kunlunliu2/Control_module_for_a_robotic_navigation_system/MyPCB5.jpg

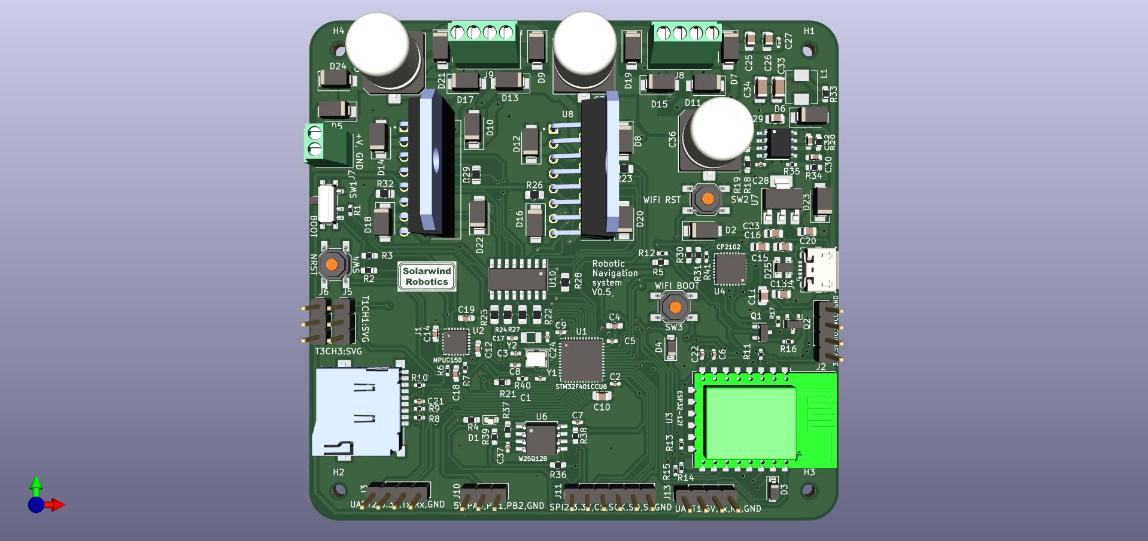
MyPCB5.jpg
