kunlunliu2/Control_module_for_a_robotic_navigation_system/README.md

# Control_module_for_a_robotic_navigation_system
This repository is my control module design for my home robot. The module will drive 4 electric motors and two other servos. It contains a ESP32 wifi, MPU9150, CP2102, L298n, and STM32F103 chips. The module is designed for recording Lidar, Gyro, and magnetic data, which are need for position recognition and motion planning. The cost of module for making and components is about $30 ~$50 depending on the manufacturing.
