kunlunliu2/Control_module_for_a_robotic_navigation_system/MyPCB5c.jpg

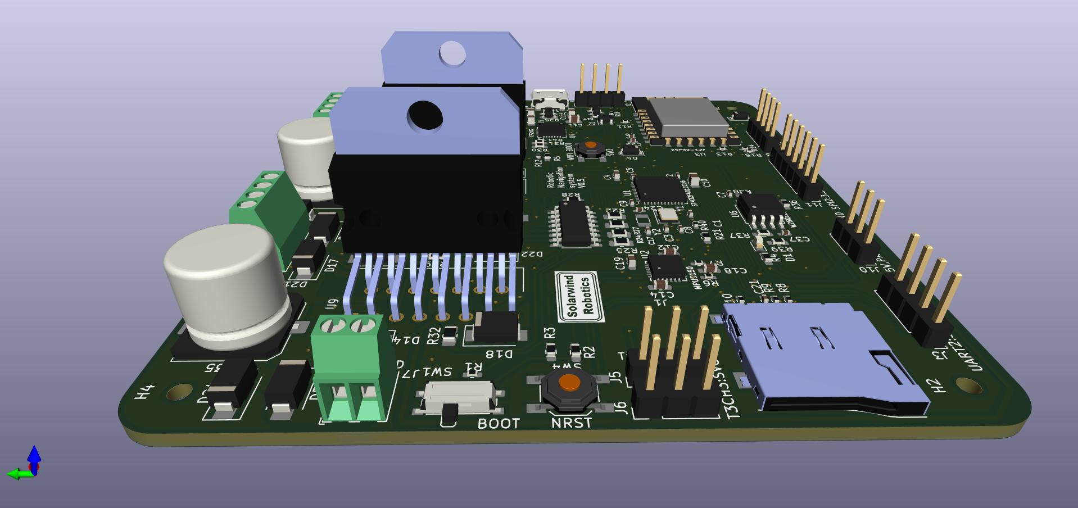
MyPCB5c.jpg
