kunlunliu2/Control_module_for_a_robotic_navigation_system/MCU.kicad_sch

## KiCad design MCU.kicad_sch (2022-03-09)

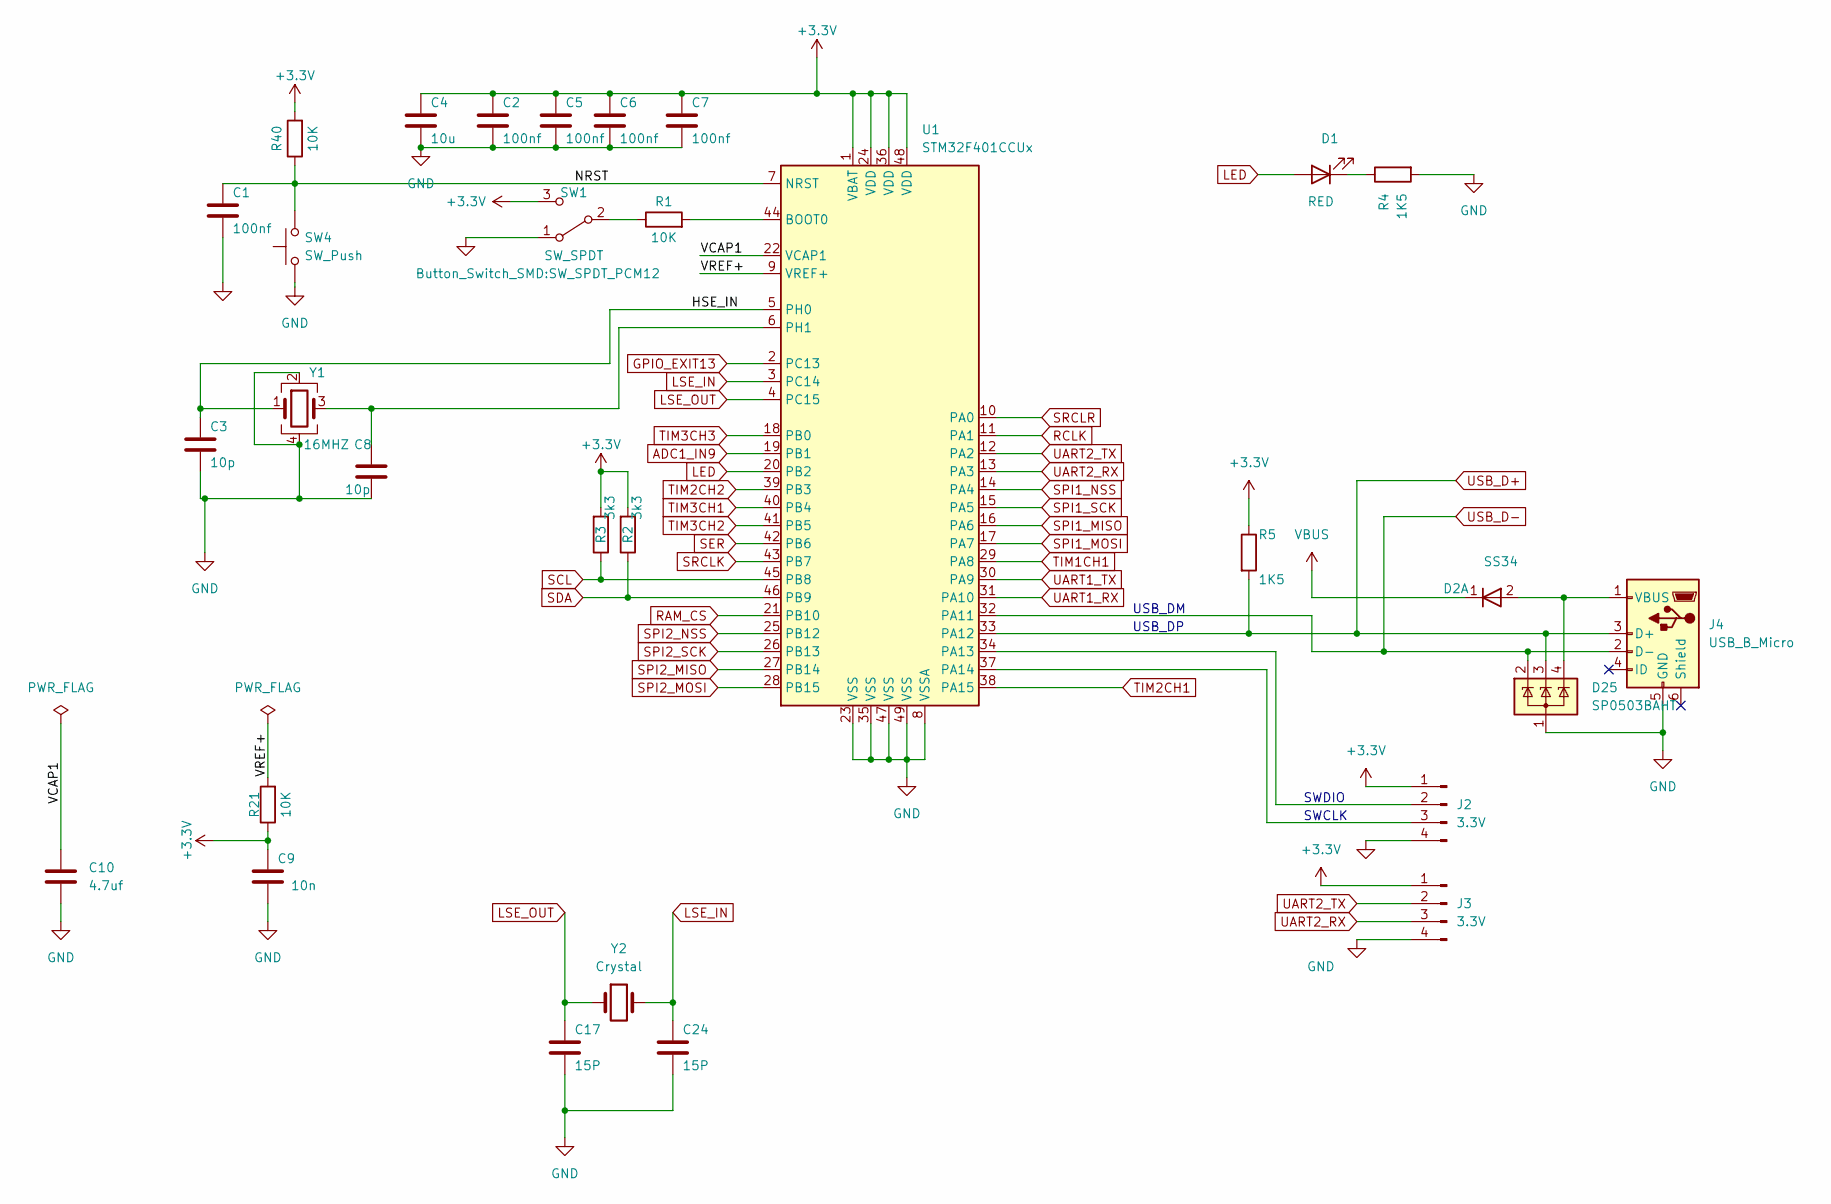
[picture p5: schematic MCU.kicad_sch]

Parts:
C1, C2, C5, C6, C7: 100nf; C_0402_1005Metric_Pad0.74x0.62mm_HandSolder; LCSC C307331
C3, C8: 10p; C_0402_1005Metric_Pad0.74x0.62mm_HandSolder; LCSC C32949
C4: 10u; C_0603_1608Metric_Pad1.08x0.95mm_HandSolder; LCSC C19702
C9: 10n; C_0402_1005Metric_Pad0.74x0.62mm_HandSolder; LCSC C15195
C10: 4.7uf; C_0805_2012Metric_Pad1.18x1.45mm_HandSolder; LCSC C1779
C17, C24: 15P; C_0402_1005Metric_Pad0.74x0.62mm_HandSolder; LCSC C1548
D1: RED; LED_0603_1608Metric; LCSC C72041
D2: SS34; D_SMA; LCSC C8678
D25: SP0503BAHT; SOT-143; LCSC C2682275
J2, J3: 3.3V; PinHeader_1x04_P2.54mm_Vertical; LCSC C358686
J4: USB_B_Micro; USB_Micro-B_Amphenol_10118194_Horizontal; LCSC C132563
R1, R40: 10K; R_0402_1005Metric_Pad0.72x0.64mm_HandSolder; LCSC C25744
R2, R3: 3k3; R_0603_1608Metric_Pad0.98x0.95mm_HandSolder; LCSC C22978
R4, R5: 1K5; R_0603_1608Metric_Pad0.98x0.95mm_HandSolder; LCSC C22843
R21: 10K; R_0603_1608Metric_Pad0.98x0.95mm_HandSolder; LCSC C25804
SW1: SW_SPDT; SW_SPDT_PCM12; LCSC C431541
SW4: SW_Push; SW_SPST_SKQG_WithoutStem; LCSC C318884
U1: STM32F401CCUx; QFN-48-1EP_7x7mm_P0.5mm_EP5.6x5.6mm
Y1: 16MHZ; Crystal_SMD_3225-4Pin_3.2x2.5mm; LCSC C13738
Y2: Crystal; Crystal_SMD_3215-2Pin_3.2x1.5mm; LCSC C32346

Connections:
+3.3V: C2.1, C4.1, C5.1, C6.1, C7.1, C9.1, J2.1, J3.1, R2.2, R3.2, R5.1, R21.1, R40.2, SW1.3 (C), U1.1 (VBAT), U1.24 (VDD), U1.36 (VDD), U1.48 (VDD)
ADC1_IN9: U1.19 (PB1)
GND: C1.2, C2.2, C3.2, C4.2, C5.2, C6.2, C7.2, C8.2, C9.2, C10.2, C17.2, C24.2, D25.1 (A), J2.4, J3.4, J4.5 (GND), R4.2, SW1.1 (A), SW4.1, U1.8 (VSSA), U1.23 (VSS), U1.35 (VSS), U1.47 (VSS), U1.49 (VSS), Y1.2, Y1.4
GPIO_EXIT13: U1.2 (PC13)
HSE_IN: C3.1, U1.5 (PH0), Y1.1
LED: D1.2 (A), U1.20 (PB2)
LSE_IN: C24.1, U1.3 (PC14), Y2.2
LSE_OUT: C17.1, U1.4 (PC15), Y2.1
NRST: C1.1, R40.1, SW4.2, U1.7 (NRST)
unnamed: C8.1, U1.6 (PH1), Y1.3
unnamed: D1.1 (K), R4.1
unnamed: D2.2 (A), D25.4 (K), J4.1 (VBUS)
unnamed: J2.2, U1.34 (PA13)
unnamed: J2.3, U1.37 (PA14)
unnamed: R1.1, SW1.2 (B)
unnamed: R1.2, U1.44 (BOOT0)
RAM_CS: U1.21 (PB10)
RCLK: U1.11 (PA1)
SCL: R3.1, U1.45 (PB8)
SDA: R2.1, U1.46 (PB9)
SER: U1.42 (PB6)
SPI1_MISO: U1.16 (PA6)
SPI1_MOSI: U1.17 (PA7)
SPI1_NSS: U1.14 (PA4)
SPI1_SCK: U1.15 (PA5)
SPI2_MISO: U1.27 (PB14)
SPI2_MOSI: U1.28 (PB15)
SPI2_NSS: U1.25 (PB12)
SPI2_SCK: U1.26 (PB13)
SRCLK: U1.43 (PB7)
SRCLR: U1.10 (PA0)
TIM1CH1: U1.29 (PA8)
TIM2CH1: U1.38 (PA15)
TIM2CH2: U1.39 (PB3)
TIM3CH1: U1.40 (PB4)
TIM3CH2: U1.41 (PB5)
TIM3CH3: U1.18 (PB0)
UART1_RX: U1.31 (PA10)
UART1_TX: U1.30 (PA9)
UART2_RX: J3.3, U1.13 (PA3)
UART2_TX: J3.2, U1.12 (PA2)
USB_D+: D25.3 (K), J4.3 (D+), R5.2, U1.33 (PA12)
USB_D-: D25.2 (K), J4.2 (D-), U1.32 (PA11)
VBUS: D2.1 (K)
VCAP1: C10.1, U1.22 (VCAP1)
VREF+: R21.2, U1.9 (VREF+)

Notes on the sheet:
SWDIO
USB_DP
USB_DM
SWCLK
