kunlunliu2/Control_module_for_a_robotic_navigation_system/MPU9150.kicad_sch

## KiCad design MPU9150.kicad_sch (2022-03-09)

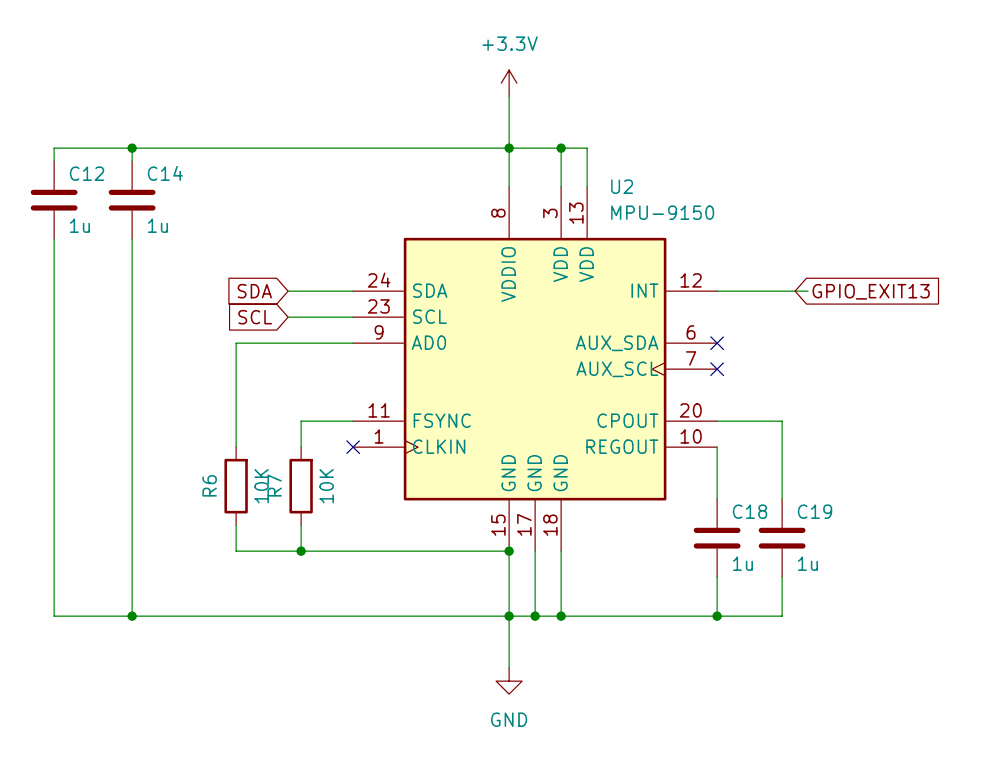
[picture p6: schematic MPU9150.kicad_sch]

Parts:
C12, C14, C18, C19: 1u; C_0603_1608Metric_Pad1.08x0.95mm_HandSolder; LCSC C15849
R6, R7: 10K; R_0402_1005Metric_Pad0.72x0.64mm_HandSolder; LCSC C25744
U2: MPU-9150; InvenSense_QFN-24_4x4mm_P0.5mm; LCSC C71459

Connections:
+3.3V: C12.1, C14.1, U2.3 (VDD), U2.8 (VDDIO), U2.13 (VDD)
GND: C12.2, C14.2, C18.2, C19.2, R6.1, R7.1, U2.15 (GND), U2.17 (GND), U2.18 (GND)
GPIO_EXIT13: U2.12 (INT)
unnamed: C18.1, U2.10 (REGOUT)
unnamed: C19.1, U2.20 (CPOUT)
unnamed: R6.2, U2.9 (AD0)
unnamed: R7.2, U2.11 (FSYNC)
SCL: U2.23 (SCL)
SDA: U2.24 (SDA)
