kunlunliu2/Control_module_for_a_robotic_navigation_system/RAM.kicad_sch

## KiCad design RAM.kicad_sch (2022-03-09)

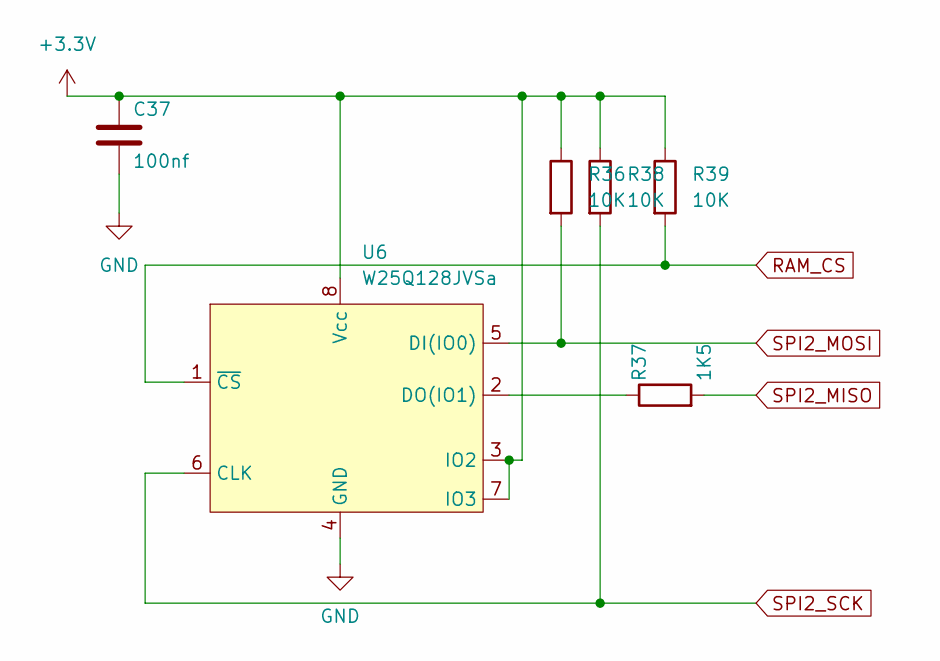
[picture p7: schematic RAM.kicad_sch]

Parts:
C37: 100nf; C_0402_1005Metric_Pad0.74x0.62mm_HandSolder; LCSC C307331
R36, R38, R39: 10K; R_0603_1608Metric_Pad0.98x0.95mm_HandSolder; LCSC C25804
R37: 1K5; R_0603_1608Metric_Pad0.98x0.95mm_HandSolder; LCSC C22843
U6: W25Q128JVSa; SOIC-8_5.23x5.23mm_P1.27mm; LCSC C97521

Connections:
+3.3V: C37.1, R36.1, R38.1, R39.1, U6.3 (IO2), U6.7 (IO3), U6.8 (Vcc)
GND: C37.2, U6.4 (GND)
unnamed: R37.1, U6.2 (DO(IO1))
RAM_CS: R39.2, U6.1 (~CS)
SPI2_MISO: R37.2
SPI2_MOSI: R36.2, U6.5 (DI(IO0))
SPI2_SCK: R38.2, U6.6 (CLK)
