kunlunliu2/Control_module_for_a_robotic_navigation_system/SD.kicad_sch

## KiCad design SD.kicad_sch (2022-03-09)

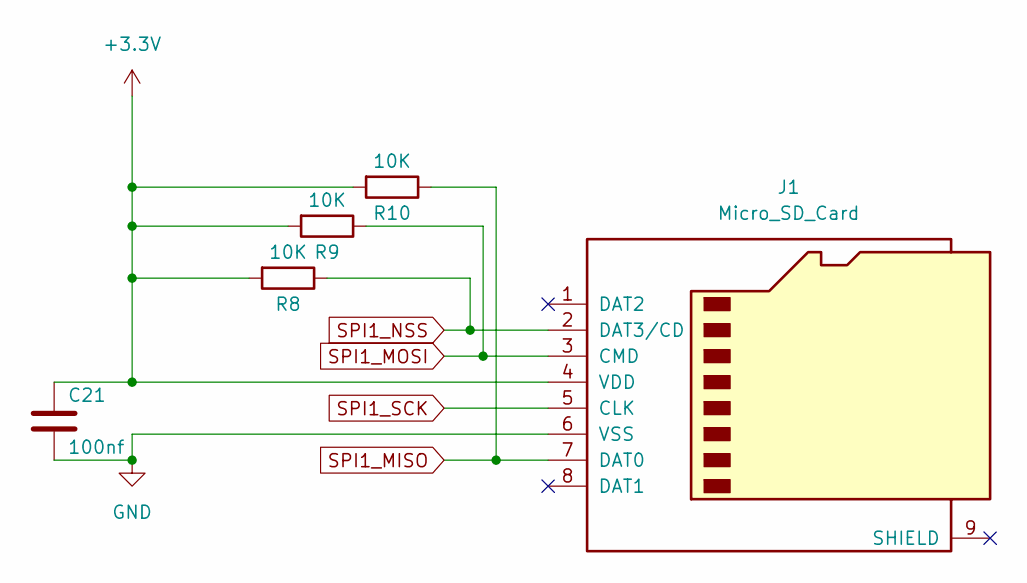
[picture p8: schematic SD.kicad_sch]

Parts:
C21: 100nf; C_0402_1005Metric_Pad0.74x0.62mm_HandSolder; LCSC C307331
J1: Micro_SD_Card; SUNTECH_ST-TF-003A; LCSC C393941
R8, R9, R10: 10K; R_0402_1005Metric_Pad0.72x0.64mm_HandSolder; LCSC C25744

Connections:
+3.3V: C21.1, J1.4 (VDD), R8.2, R9.2, R10.2
GND: C21.2, J1.6 (VSS)
SPI1_MISO: J1.7 (DAT0), R10.1
SPI1_MOSI: J1.3 (CMD), R9.1
SPI1_NSS: J1.2 (DAT3/CD), R8.1
SPI1_SCK: J1.5 (CLK)
