kunlunliu2/Control_module_for_a_robotic_navigation_system/port.kicad_sch

## KiCad design port.kicad_sch (2022-03-09)

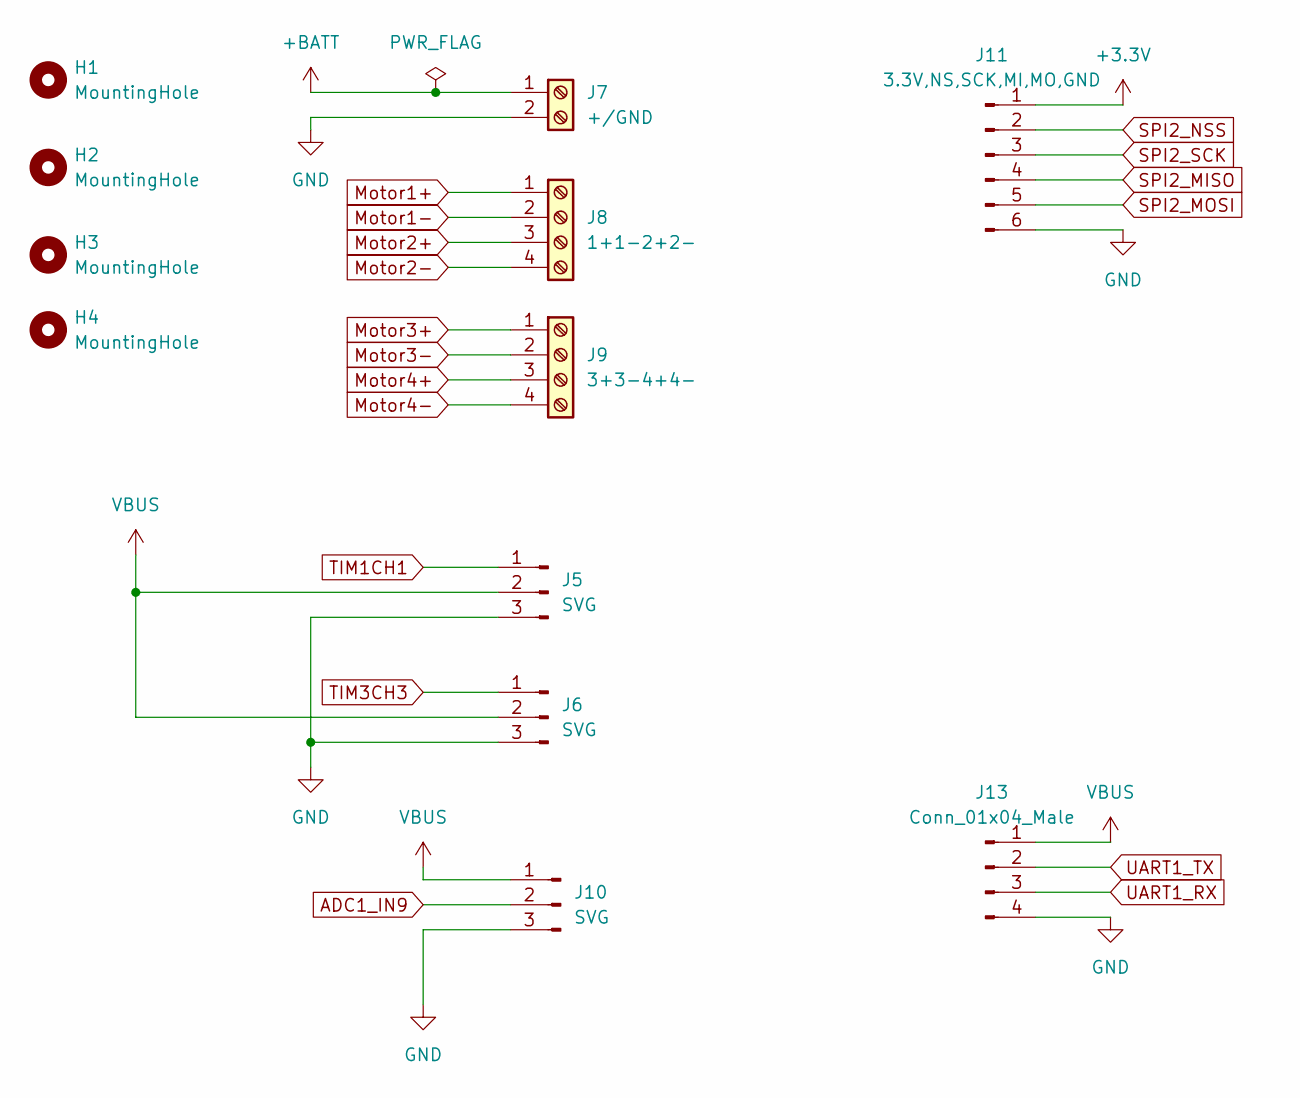
[picture p9: schematic port.kicad_sch]

Parts:
H1, H2, H3, H4: MountingHole; MountingHole_2.2mm_M2
J5, J6, J10: SVG; PinHeader_1x03_P2.54mm_Vertical; LCSC C49257
J7: +/GND; TerminalBlock_Phoenix_MPT-0,5-2-2.54_1x02_P2.54mm_Horizontal; LCSC C474920
J8: 1+1-2+2-; TerminalBlock_Phoenix_MPT-0,5-4-2.54_1x04_P2.54mm_Horizontal; LCSC C474922
J9: 3+3-4+4-; TerminalBlock_Phoenix_MPT-0,5-4-2.54_1x04_P2.54mm_Horizontal; LCSC C474922
J11: 3.3V,NS,SCK,MI,MO,GND; PinHeader_1x06_P2.54mm_Vertical; LCSC C37208
J13: Conn_01x04_Male; PinHeader_1x04_P2.54mm_Vertical; LCSC C272953

Connections:
+3.3V: J11.1
+BATT: J7.1
ADC1_IN9: J10.2
GND: J5.3, J6.3, J7.2, J10.3, J11.6, J13.4
Motor1+: J8.1
Motor1-: J8.2
Motor2+: J8.3
Motor2-: J8.4
Motor3+: J9.1
Motor3-: J9.2
Motor4+: J9.3
Motor4-: J9.4
SPI2_MISO: J11.4
SPI2_MOSI: J11.5
SPI2_NSS: J11.2
SPI2_SCK: J11.3
TIM1CH1: J5.1
TIM3CH3: J6.1
UART1_RX: J13.3
UART1_TX: J13.2
VBUS: J5.2, J6.2, J10.1, J13.1
