kunlunliu2/Control_module_for_a_robotic_navigation_system/power_motor.kicad_sch

## KiCad design power_motor.kicad_sch (2022-03-09)

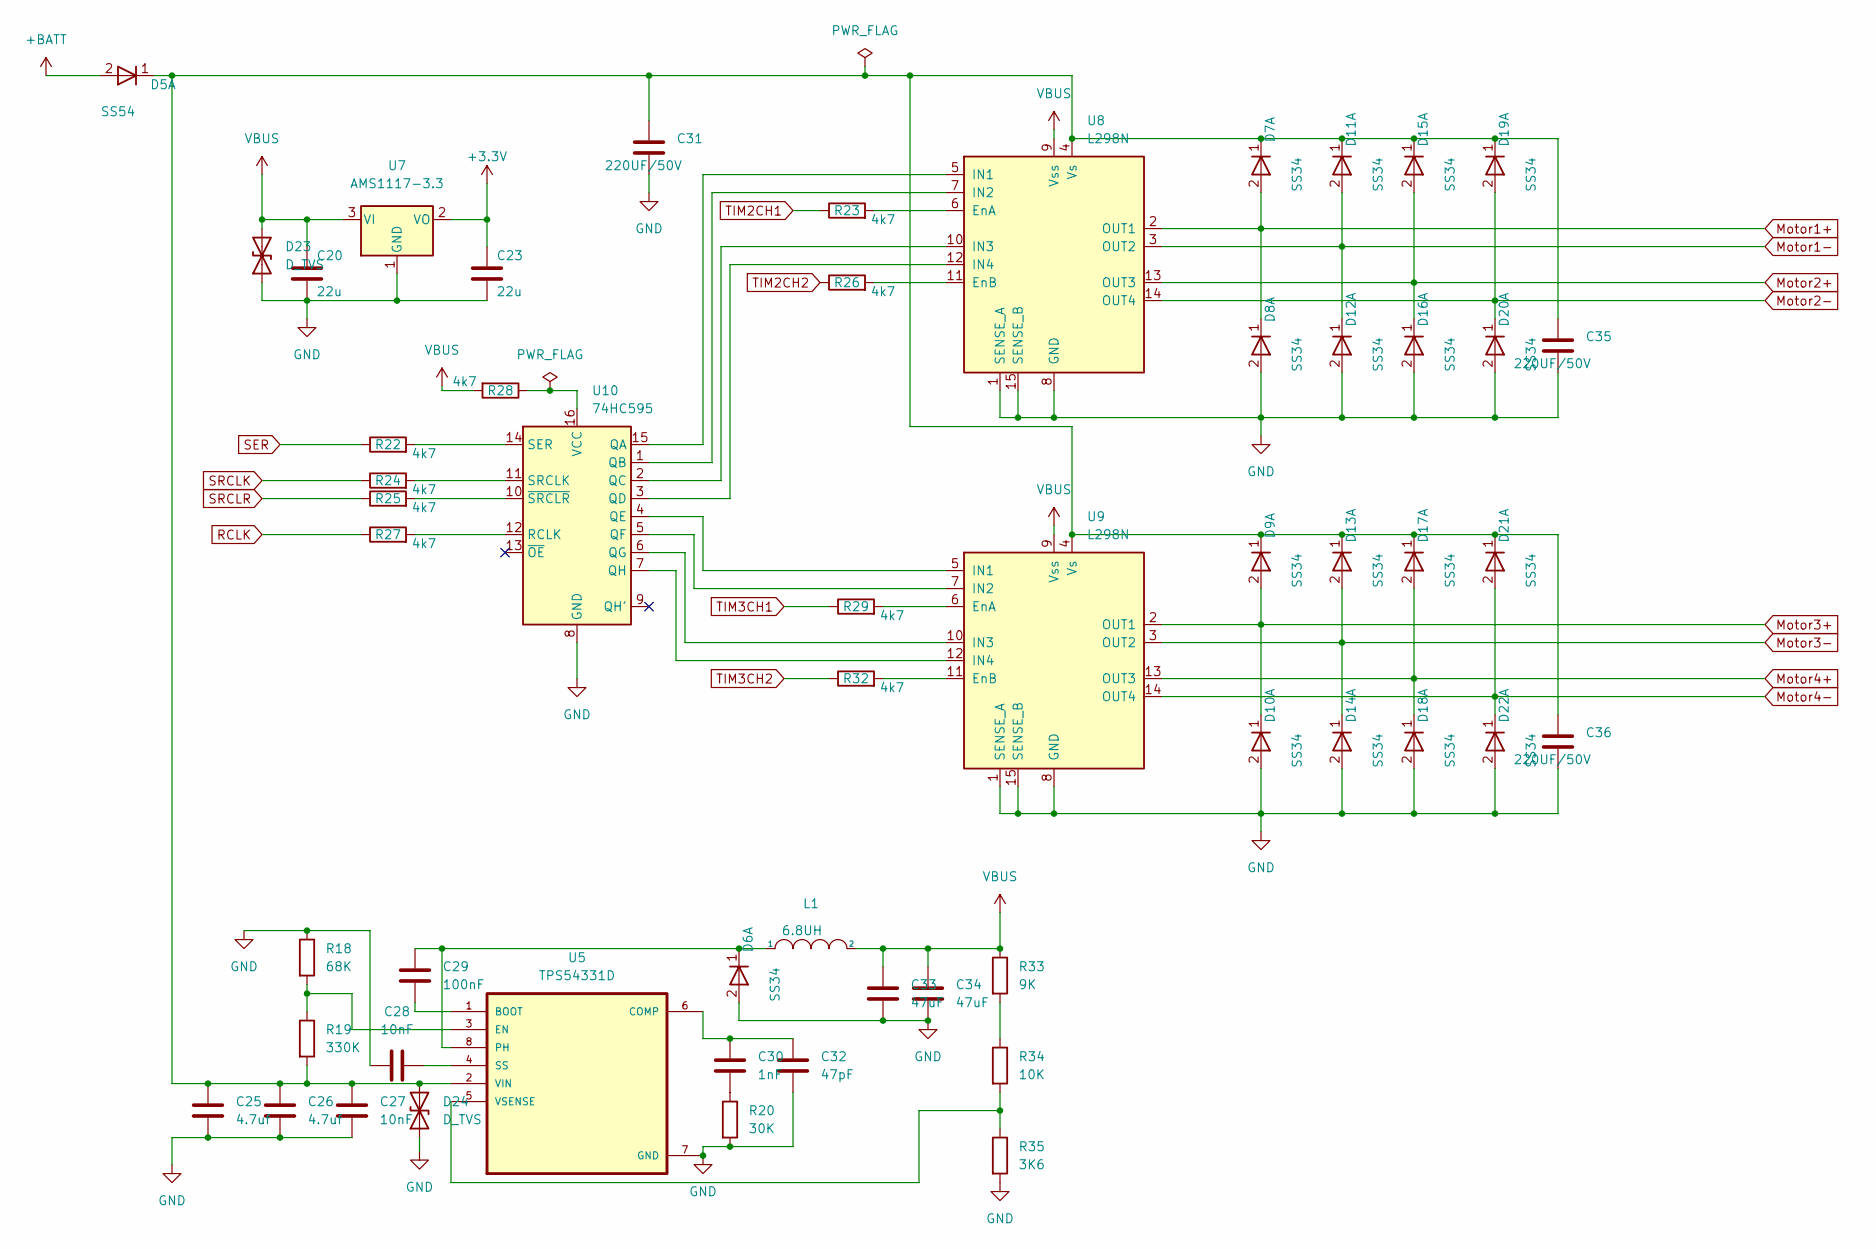
[picture p10: schematic power_motor.kicad_sch]

Parts:
C20, C23: 22u; C_0805_2012Metric_Pad1.18x1.45mm_HandSolder; LCSC C45783
C25, C26: 4.7uf; C_0805_2012Metric_Pad1.18x1.45mm_HandSolder; LCSC C1779
C27, C28: 10nF; C_0402_1005Metric_Pad0.74x0.62mm_HandSolder; LCSC C15195
C29: 100nF; C_0805_2012Metric_Pad1.18x1.45mm_HandSolder; LCSC C49678
C30: 1nF; C_0603_1608Metric_Pad1.08x0.95mm_HandSolder; LCSC C1588
C31, C35, C36: 220UF/50V; C_Elec_10x10.2; LCSC C125977
C32: 47pF; C_0603_1608Metric_Pad1.08x0.95mm_HandSolder; LCSC C1671
C33, C34: 47uF; C_1206_3216Metric_Pad1.33x1.80mm_HandSolder; LCSC C96123
D5: SS54; D_SMA; LCSC C22452
D6, D7, D8, D9, D10, D11, D12, D13, D14, D15, D16, D17, D18, D19, D20, D21, D22: SS34; D_SMA; LCSC C8678
D23, D24: D_TVS; D_SMA; LCSC C78400
L1: 6.8UH; L_Sunlord_MWSA0518_5.4x5.2mm; LCSC C325965
R18: 68K; R_0603_1608Metric_Pad0.98x0.95mm_HandSolder; LCSC C23231
R19: 330K; R_0603_1608Metric_Pad0.98x0.95mm_HandSolder; LCSC C23137
R20: 30K; R_0603_1608Metric_Pad0.98x0.95mm_HandSolder; LCSC C23024
R22, R23, R24, R25, R26, R27, R28, R29, R32: 4k7; R_0805_2012Metric_Pad1.20x1.40mm_HandSolder; LCSC C17673
R33: 9K; R_0603_1608Metric_Pad0.98x0.95mm_HandSolder; LCSC C23185
R34: 10K; R_0603_1608Metric_Pad0.98x0.95mm_HandSolder; LCSC C25804
R35: 3K6; R_0402_1005Metric_Pad0.72x0.64mm_HandSolder; LCSC C22980
U5: TPS54331D; SOIC127P599X175-8N; LCSC C9865
U7: AMS1117-3.3; SOT-223-3_TabPin2; LCSC C6186
U8, U9: L298N; TO127P2020X500X2100-15; LCSC C910880
U10: 74HC595; SOIC-16_3.9x9.9mm_P1.27mm; LCSC C5947

Connections:
+3.3V: C23.1, U7.2 (VO)
+BATT: D5.2 (A)
GND: C20.2, C23.2, C25.2, C26.2, C27.2, C28.1, C31.2, C32.2, C33.2, C34.2, C35.2, C36.2, D6.2 (A), D8.2 (A), D10.2 (A), D12.2 (A), D14.2 (A), D16.2 (A), D18.2 (A), D20.2 (A), D22.2 (A), D23.1 (A1), D24.1 (A1), R18.1, R20.2, R35.2, U5.7 (GND), U7.1 (GND), U8.1 (SENSE_A), U8.8 (GND), U8.15 (SENSE_B), U9.1 (SENSE_A), U9.8 (GND), U9.15 (SENSE_B), U10.8 (GND)
Motor1+: D7.2 (A), D8.1 (K), U8.2 (OUT1)
Motor1-: D11.2 (A), D12.1 (K), U8.3 (OUT2)
Motor2+: D15.2 (A), D16.1 (K), U8.13 (OUT3)
Motor2-: D19.2 (A), D20.1 (K), U8.14 (OUT4)
Motor3+: D9.2 (A), D10.1 (K), U9.2 (OUT1)
Motor3-: D13.2 (A), D14.1 (K), U9.3 (OUT2)
Motor4+: D17.2 (A), D18.1 (K), U9.13 (OUT3)
Motor4-: D21.2 (A), D22.1 (K), U9.14 (OUT4)
unnamed: C25.1, C26.1, C27.1, C31.1, C35.1, C36.1, D5.1 (K), D7.1 (K), D9.1 (K), D11.1 (K), D13.1 (K), D15.1 (K), D17.1 (K), D19.1 (K), D21.1 (K), D24.2 (A2), R19.2, U5.2 (VIN), U8.4 (Vs), U9.4 (Vs)
unnamed: C28.2, U5.4 (SS)
unnamed: C29.1, D6.1 (K), L1.1, U5.8 (PH)
unnamed: C29.2, U5.1 (BOOT)
unnamed: C30.1, C32.1, U5.6 (COMP)
unnamed: C30.2, R20.1
unnamed: R18.2, R19.1, U5.3 (EN)
unnamed: R22.2, U10.14 (SER)
unnamed: R23.2, U8.6 (EnA)
unnamed: R24.2, U10.11 (SRCLK)
unnamed: R25.2, U10.10 (~SRCLR)
unnamed: R26.2, U8.11 (EnB)
unnamed: R27.2, U10.12 (RCLK)
unnamed: R28.1, U10.16 (VCC)
unnamed: R29.2, U9.6 (EnA)
unnamed: R32.2, U9.11 (EnB)
unnamed: R33.2, R34.1
unnamed: R34.2, R35.1, U5.5 (VSENSE)
unnamed: U8.7 (IN2), U10.1 (QB)
unnamed: U8.10 (IN3), U10.2 (QC)
unnamed: U8.12 (IN4), U10.3 (QD)
unnamed: U9.5 (IN1), U10.4 (QE)
unnamed: U9.7 (IN2), U10.5 (QF)
unnamed: U9.10 (IN3), U10.6 (QG)
unnamed: U9.12 (IN4), U10.7 (QH)
unnamed: U8.5 (IN1), U10.15 (QA)
RCLK: R27.1
SER: R22.1
SRCLK: R24.1
SRCLR: R25.1
TIM2CH1: R23.1
TIM2CH2: R26.1
TIM3CH1: R29.1
TIM3CH2: R32.1
VBUS: C20.1, C33.1, C34.1, D23.2 (A2), L1.2, R28.2, R33.1, U7.3 (VI), U8.9 (Vss), U9.9 (Vss)
