kunlunliu2/Control_module_for_a_robotic_navigation_system/wifi.kicad_sch

## KiCad design wifi.kicad_sch (2022-03-09)

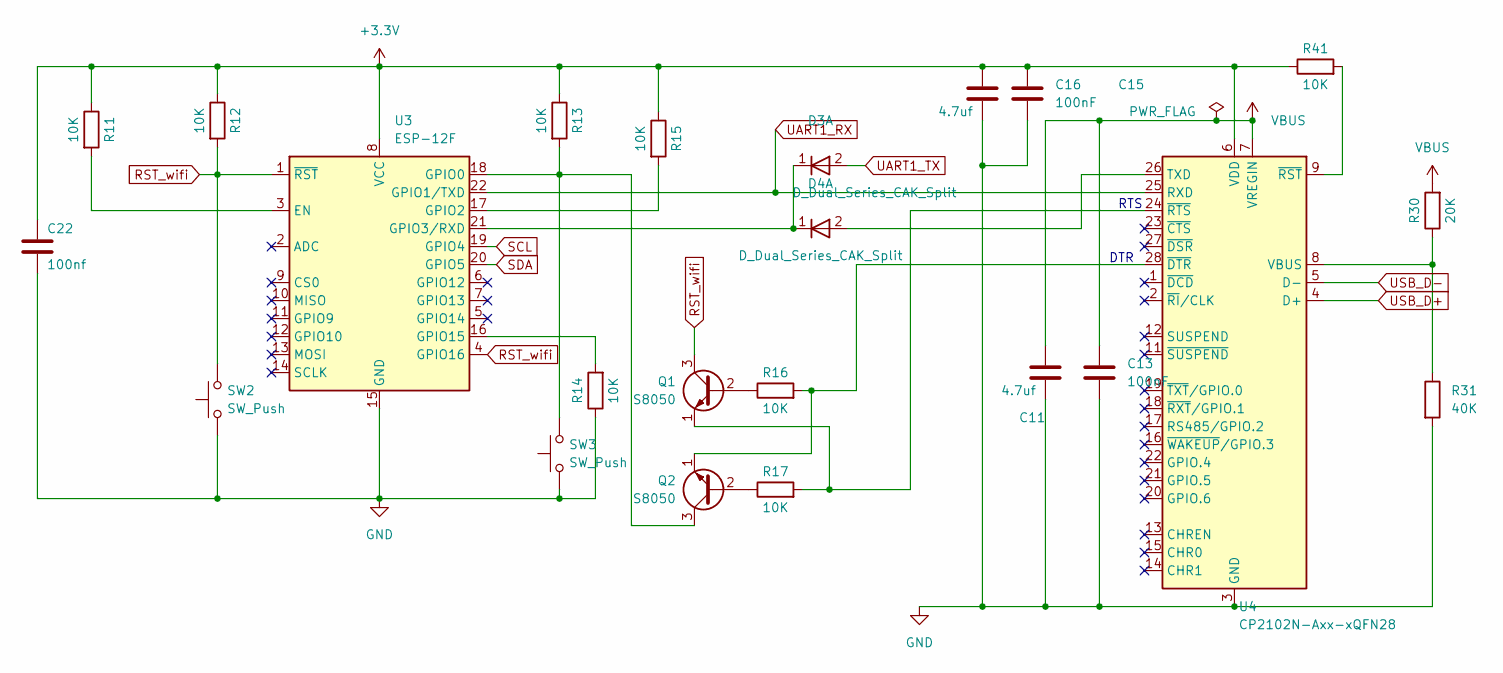
[picture p11: schematic wifi.kicad_sch]

Parts:
C11, C15: 4.7uf; C_0805_2012Metric_Pad1.18x1.45mm_HandSolder; LCSC C1779
C13, C16: 100nF; C_0805_2012Metric_Pad1.18x1.45mm_HandSolder; LCSC C49678
C22: 100nf; C_0402_1005Metric_Pad0.74x0.62mm_HandSolder; LCSC C307331
D3, D4: D_Dual_Series_CAK_Split; D_SOD-123; LCSC C8598
Q1, Q2: S8050; SOT-23; LCSC C2146
R11, R12, R13, R14, R15, R16, R17, R41: 10K; R_0402_1005Metric_Pad0.72x0.64mm_HandSolder; LCSC C25744
R30: 20K; R_0603_1608Metric_Pad0.98x0.95mm_HandSolder; LCSC C22939
R31: 40K; R_0603_1608Metric_Pad0.98x0.95mm_HandSolder; LCSC C4197
SW2, SW3: SW_Push; SW_SPST_SKQG_WithoutStem; LCSC C318884
U3: ESP-12F; ESP-12E; LCSC C82891
U4: CP2102N-Axx-xQFN28; QFN-28-1EP_5x5mm_P0.5mm_EP3.35x3.35mm; LCSC C6568

Connections:
+3.3V: C15.1, C16.1, C22.1, R11.1, R12.1, R13.1, R15.1, R41.1, U3.8 (VCC), U4.6 (VDD)
GND: C11.2, C13.2, C15.2, C16.2, C22.2, R14.1, R31.2, SW2.1, SW3.1, U3.15 (GND), U4.3 (GND), U4.29 (GND)
unnamed: D3.1 (K), D4.1 (K), U3.21 (GPIO3/RXD)
unnamed: D4.2 (A), U4.26 (TXD)
unnamed: Q1.1 (E), R17.2, U4.24 (~RTS)
unnamed: Q1.2 (B), R16.1
unnamed: Q2.1 (E), R16.2, U4.28 (~DTR)
unnamed: Q2.2 (B), R17.1
unnamed: Q2.3 (C), R13.2, SW3.2, U3.18 (GPIO0)
unnamed: R11.2, U3.3 (EN)
unnamed: R14.2, U3.16 (GPIO15)
unnamed: R15.2, U3.17 (GPIO2)
unnamed: R30.1, R31.1, U4.8 (VBUS)
unnamed: R41.2, U4.9 (~RST)
RST_wifi: Q1.3 (C), R12.2, SW2.2, U3.1 (~RST), U3.4 (GPIO16)
SCL: U3.19 (GPIO4)
SDA: U3.20 (GPIO5)
UART1_RX: U3.22 (GPIO1/TXD), U4.25 (RXD)
UART1_TX: D3.2 (A)
USB_D+: U4.4 (D+)
USB_D-: U4.5 (D-)
VBUS: C11.1, C13.1, R30.2, U4.7 (VREGIN)

Notes on the sheet:
RTS
DTR
